mfkiwl/vigoleno-V1.0-A13SOM/Documents/https.docx

Ram

https://www.digikey.com/products/en/integrated-circuits-ics/memory/774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

Nand

https://www.digikey.com/product-detail/en/cypress-semiconductor-corp/S34ML08G201TFI000/1274-1099-ND/4457676

Resitor networks

22R

https://www.digikey.in/product-detail/en/yageo/YC124-JR-0722RL/YC124J-22CT-ND/1005508

10K

https://www.digikey.com/product-detail/en/yageo/YC124-JR-0710KL/YC124J-10KCT-ND/1005575

100K

https://www.digikey.com/product-detail/en/samsung-electro-mechanics/RP104PJ104CS/1276-6113-1-ND/3969085

Power

1.2V

https://www.digikey.in/product-detail/en/renesas-electronics-america-inc/ISL8022IRZ/ISL8022IRZ-ND/2360908

1.5V

https://www.digikey.in/product-detail/en/texas-instruments/TLV62569PDDCT/296-47088-1-ND/7596469

3.0V

https://www.digikey.in/product-detail/en/texas-instruments/TPS62233DRYR/296-46475-1-ND/7033648

3.3V & 5.0V

http://thegioiic.com/products/xl4015

SN74ALVC244DGVR

https://www.digikey.com/product-detail/en/texas-instruments/SN74ALVC244DGVR/296-12862-1-ND/475995

2.2uH/2.1A INDUCTOR

https://www.digikey.com/product-detail/en/bourns-inc/SRN2512-2R2M/SRN2512-2R2MCT-ND/4867759

47uH/6.5A INDUCTOR

https://www.digikey.com/product-detail/en/bourns-inc/SRP1265A-470M/SRP1265A-470MCT-ND/4876720

USB SWITCH

https://www.digikey.com/product-detail/en/texas-instruments/TPS2066CD/296-30609-5-ND/3487218

VGA CONNECTOR

https://www.digikey.com/product-detail/en/omron-electronics-inc-emc-div/XM4L-1542-132/OR1096-ND/1829580

CMOS BATTERY

https://shopee.vn/Pin-ngu%E1%BB%93n-3-6v-60mA-4h-6mA-i.20802805.1079670766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

POWER SWITCH

https://www.digikey.com/product-detail/en/linear-technology-analog-devices/LTC4412HVIS6-TRPBF/LTC4412HVIS6-TRPBFCT-ND/4694483

HEATSINK

https://shopee.vn/Nh%C3%B4m-t%E1%BA%A3n-nhi%E1%BB%87t-h%C3%A0ng-nh%E1%BA%ADp-kh%E1%BA%A9u-8cm-x-8cm-x-0.7cm-i.87361431.1483501040

RIPPER FILTER INDUCTOR 10uH/4.5A

https://www.digikey.com/product-detail/en/eaton/DR124-100-R/513-1431-1-ND/1555580

EEPROM

https://www.digikey.com/product-detail/en/microchip-technology/93LC66AT-I-OT/93LC66AT-I-OTCT-ND/857647

SCHOTTKY DIODE 10A/60V

https://www.digikey.com/product-detail/en/micro-commercial-co/SK106-TP/SK106-TPCT-ND/1306213

LM317

https://www.digikey.com/product-detail/en/on-semiconductor/LM317BD2TR4G/LM317BD2TR4GOSCT-ND/917939

ON/OFF SWITCH FOR POWER SUPPLY

https://sptshoponline.com/san-pham/cong-tac-bap-benh-6-chan-cong-tac-dao-chieu/
