mfkiwl/vigoleno-V1.0-A13SOM/Documents/BLX-A.pdf

## QuickTec sikringsholder BLX-A:

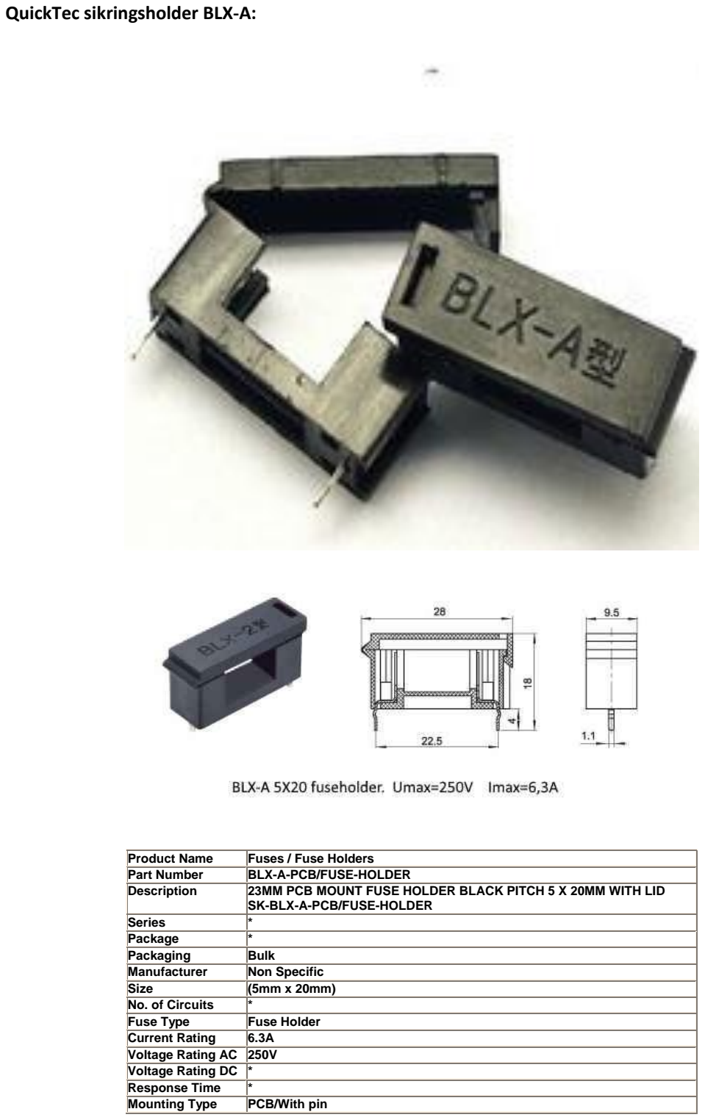
[picture p1: page 1]

Product Name | Fuses / Fuse Holders
Part Number | BLX-A-PCB/FUSE-HOLDER
Description | 23MM PCB MOUNT FUSE HOLDER BLACK PITCH 5 X 20MM WITH LID SK-BLX-A-PCB/FUSE-HOLDER
Series | *
Package | *
Packaging | Bulk
Manufacturer | Non Specific
Size | (5mm x 20mm)
No. of Circuits | *
Fuse Type | Fuse Holder
Current Rating | 6.3A
Voltage Rating AC | 250V
Voltage Rating DC | *
Response Time | *
Mounting Type | PCB/With pin
