mfkiwl/vigoleno-V1.0-A13SOM/PCB/vigoleno/vigoleno-F.Cu.dxf

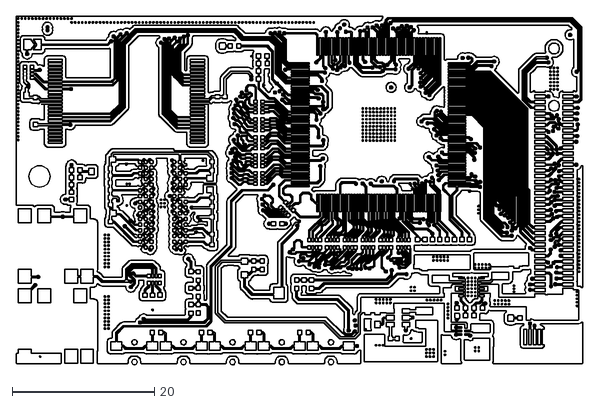
[picture p2: CAD file, 2019-08-09]
PCB/vigoleno/vigoleno-F.Cu.dxf
79.6 x 48.9
