mfkiwl/vigoleno-V1.0-A13SOM/PCB/vigoleno/vigoleno-Edge.Cuts.dxf

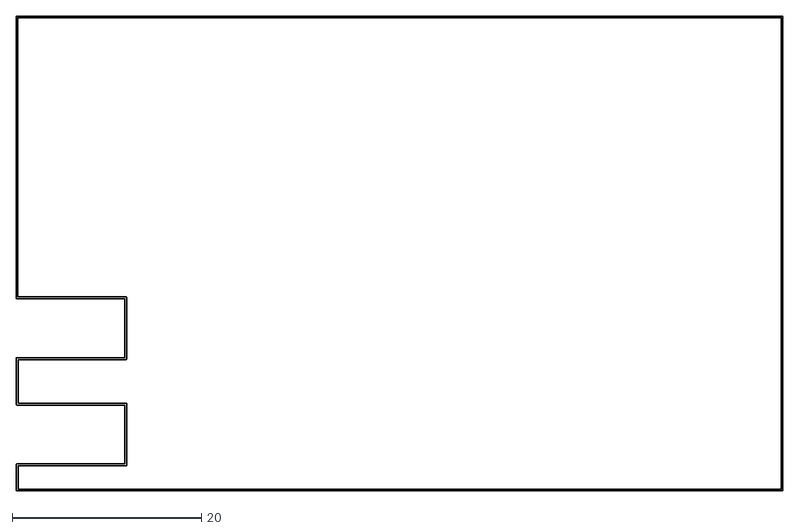
[picture p3: CAD file, 2019-08-09]
PCB/vigoleno/vigoleno-Edge.Cuts.dxf
81.0 x 50.2
