mfkiwl/vigoleno-V1.0-A13SOM/(list of files, cad)

Other CAD files:
PCB/vigoleno/vigoleno-F.SilkS.dxf
