mfkiwl/vigoleno-V1.0-A13SOM/Documents/2631-2XXMXXXTNXX.pdf

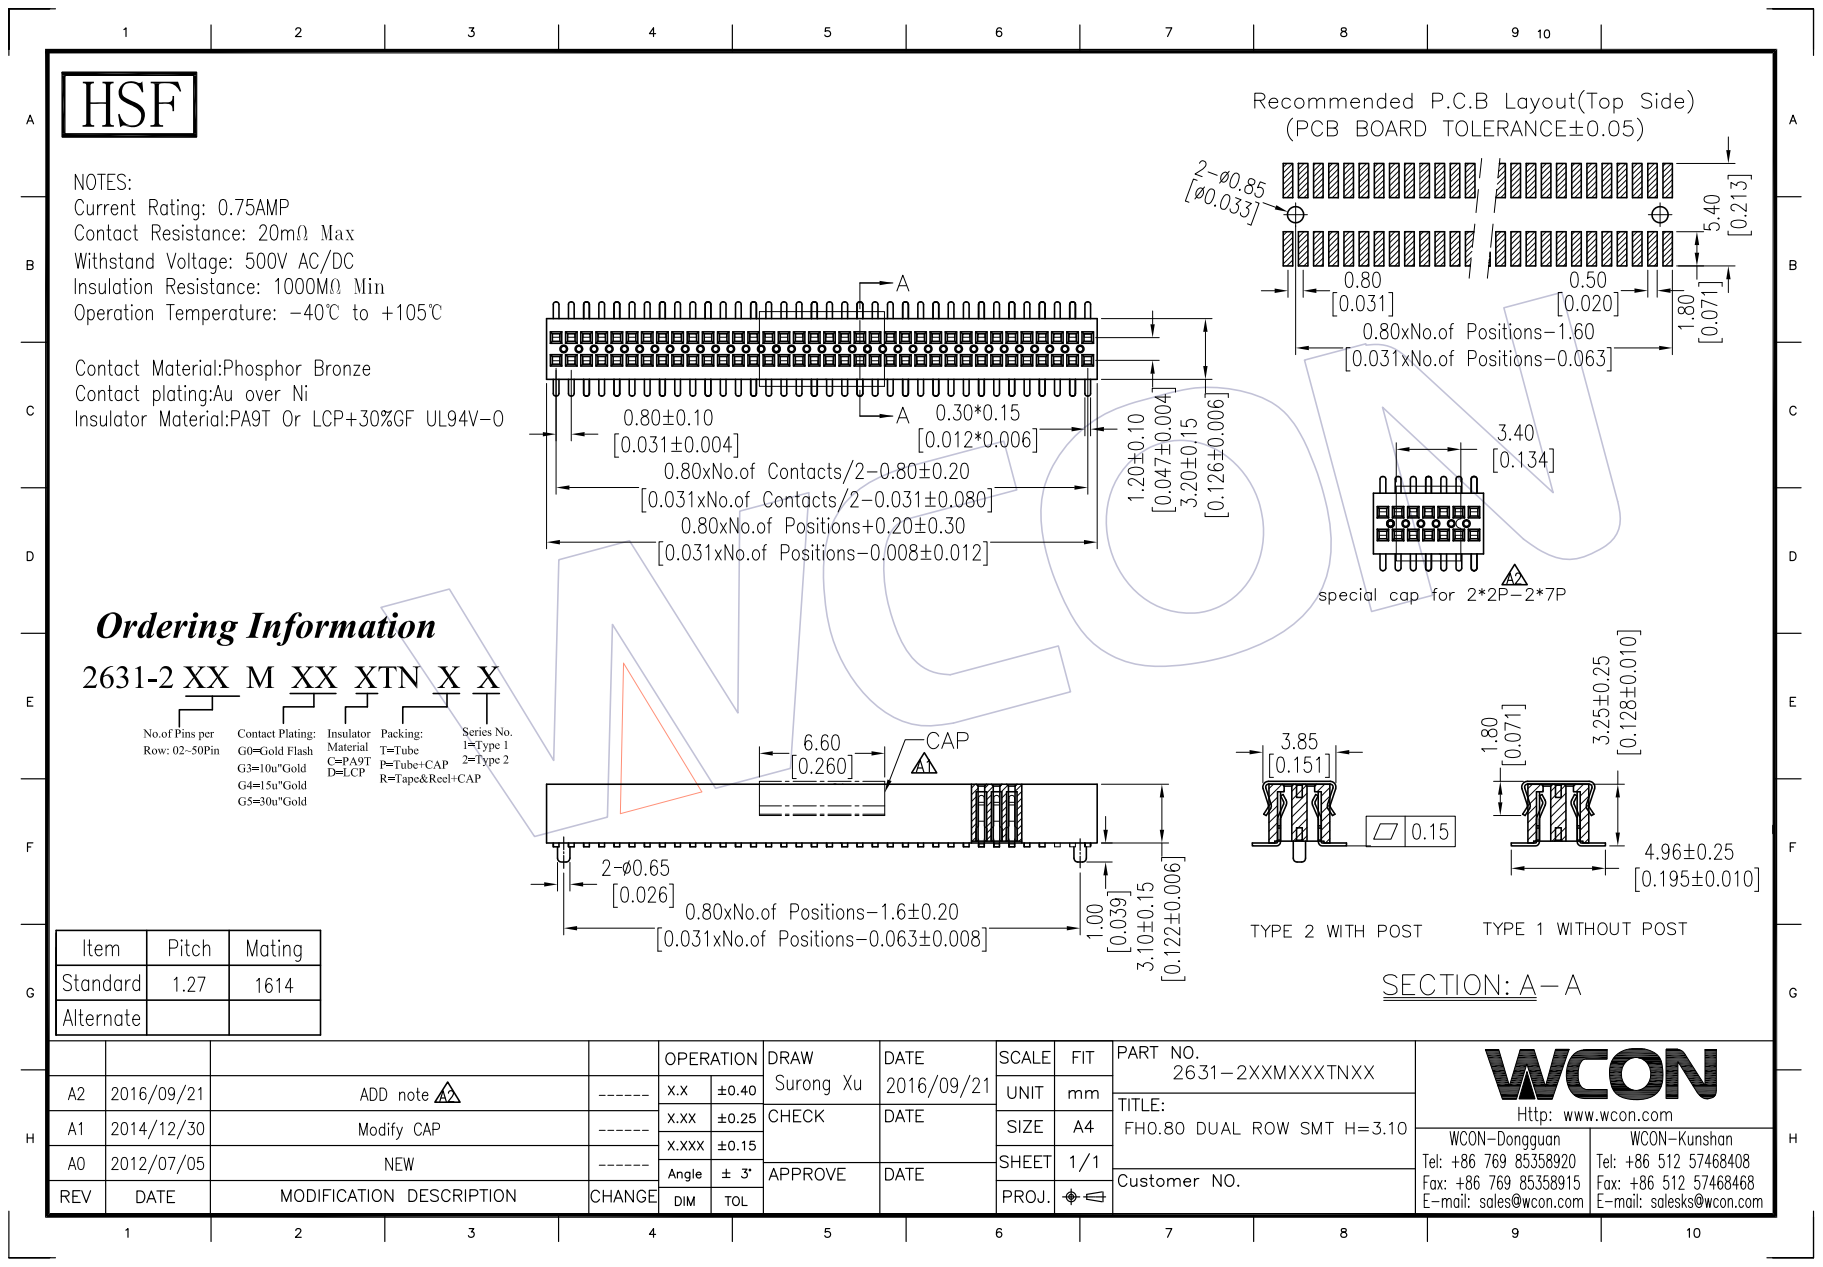
[picture p4: page 1]
