mfkiwl/vigoleno-V1.0-A13SOM/PCB/vigoleno/vigoleno.kicad_pcb

## KiCad design PCB/vigoleno/vigoleno.kicad_pcb (2019-08-09)

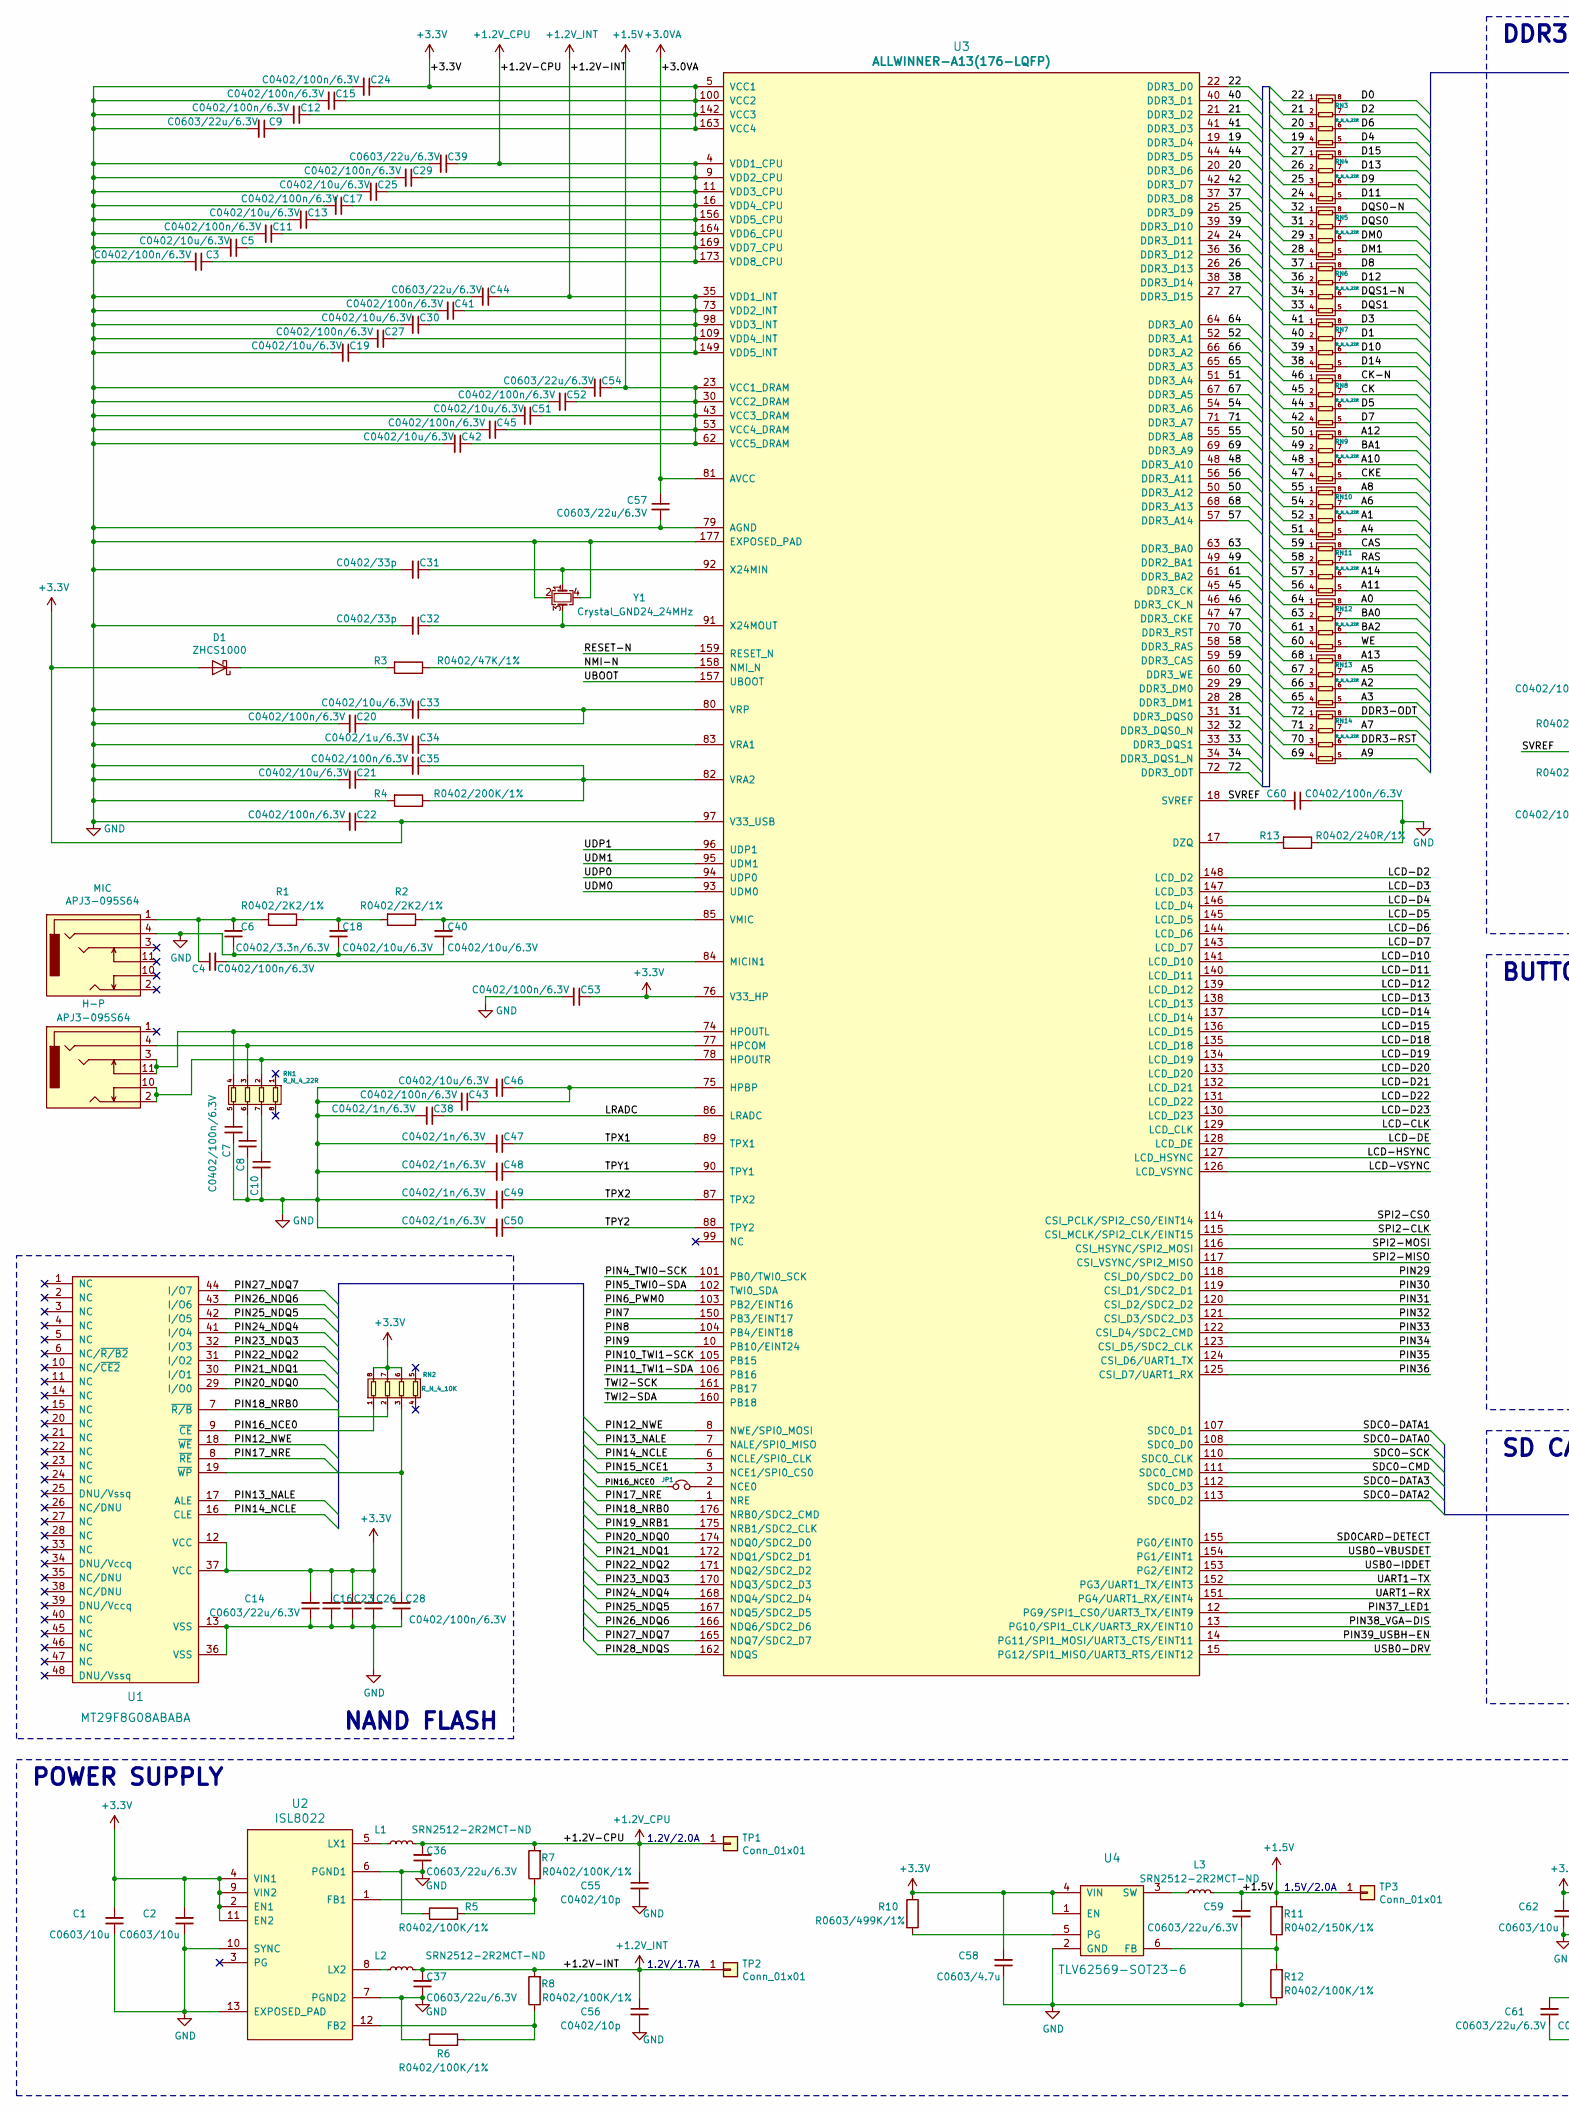
[picture p5: schematic vigoleno.sch, VIGOLENO SYSTEM ON MODULE, part in row 1, column 1]

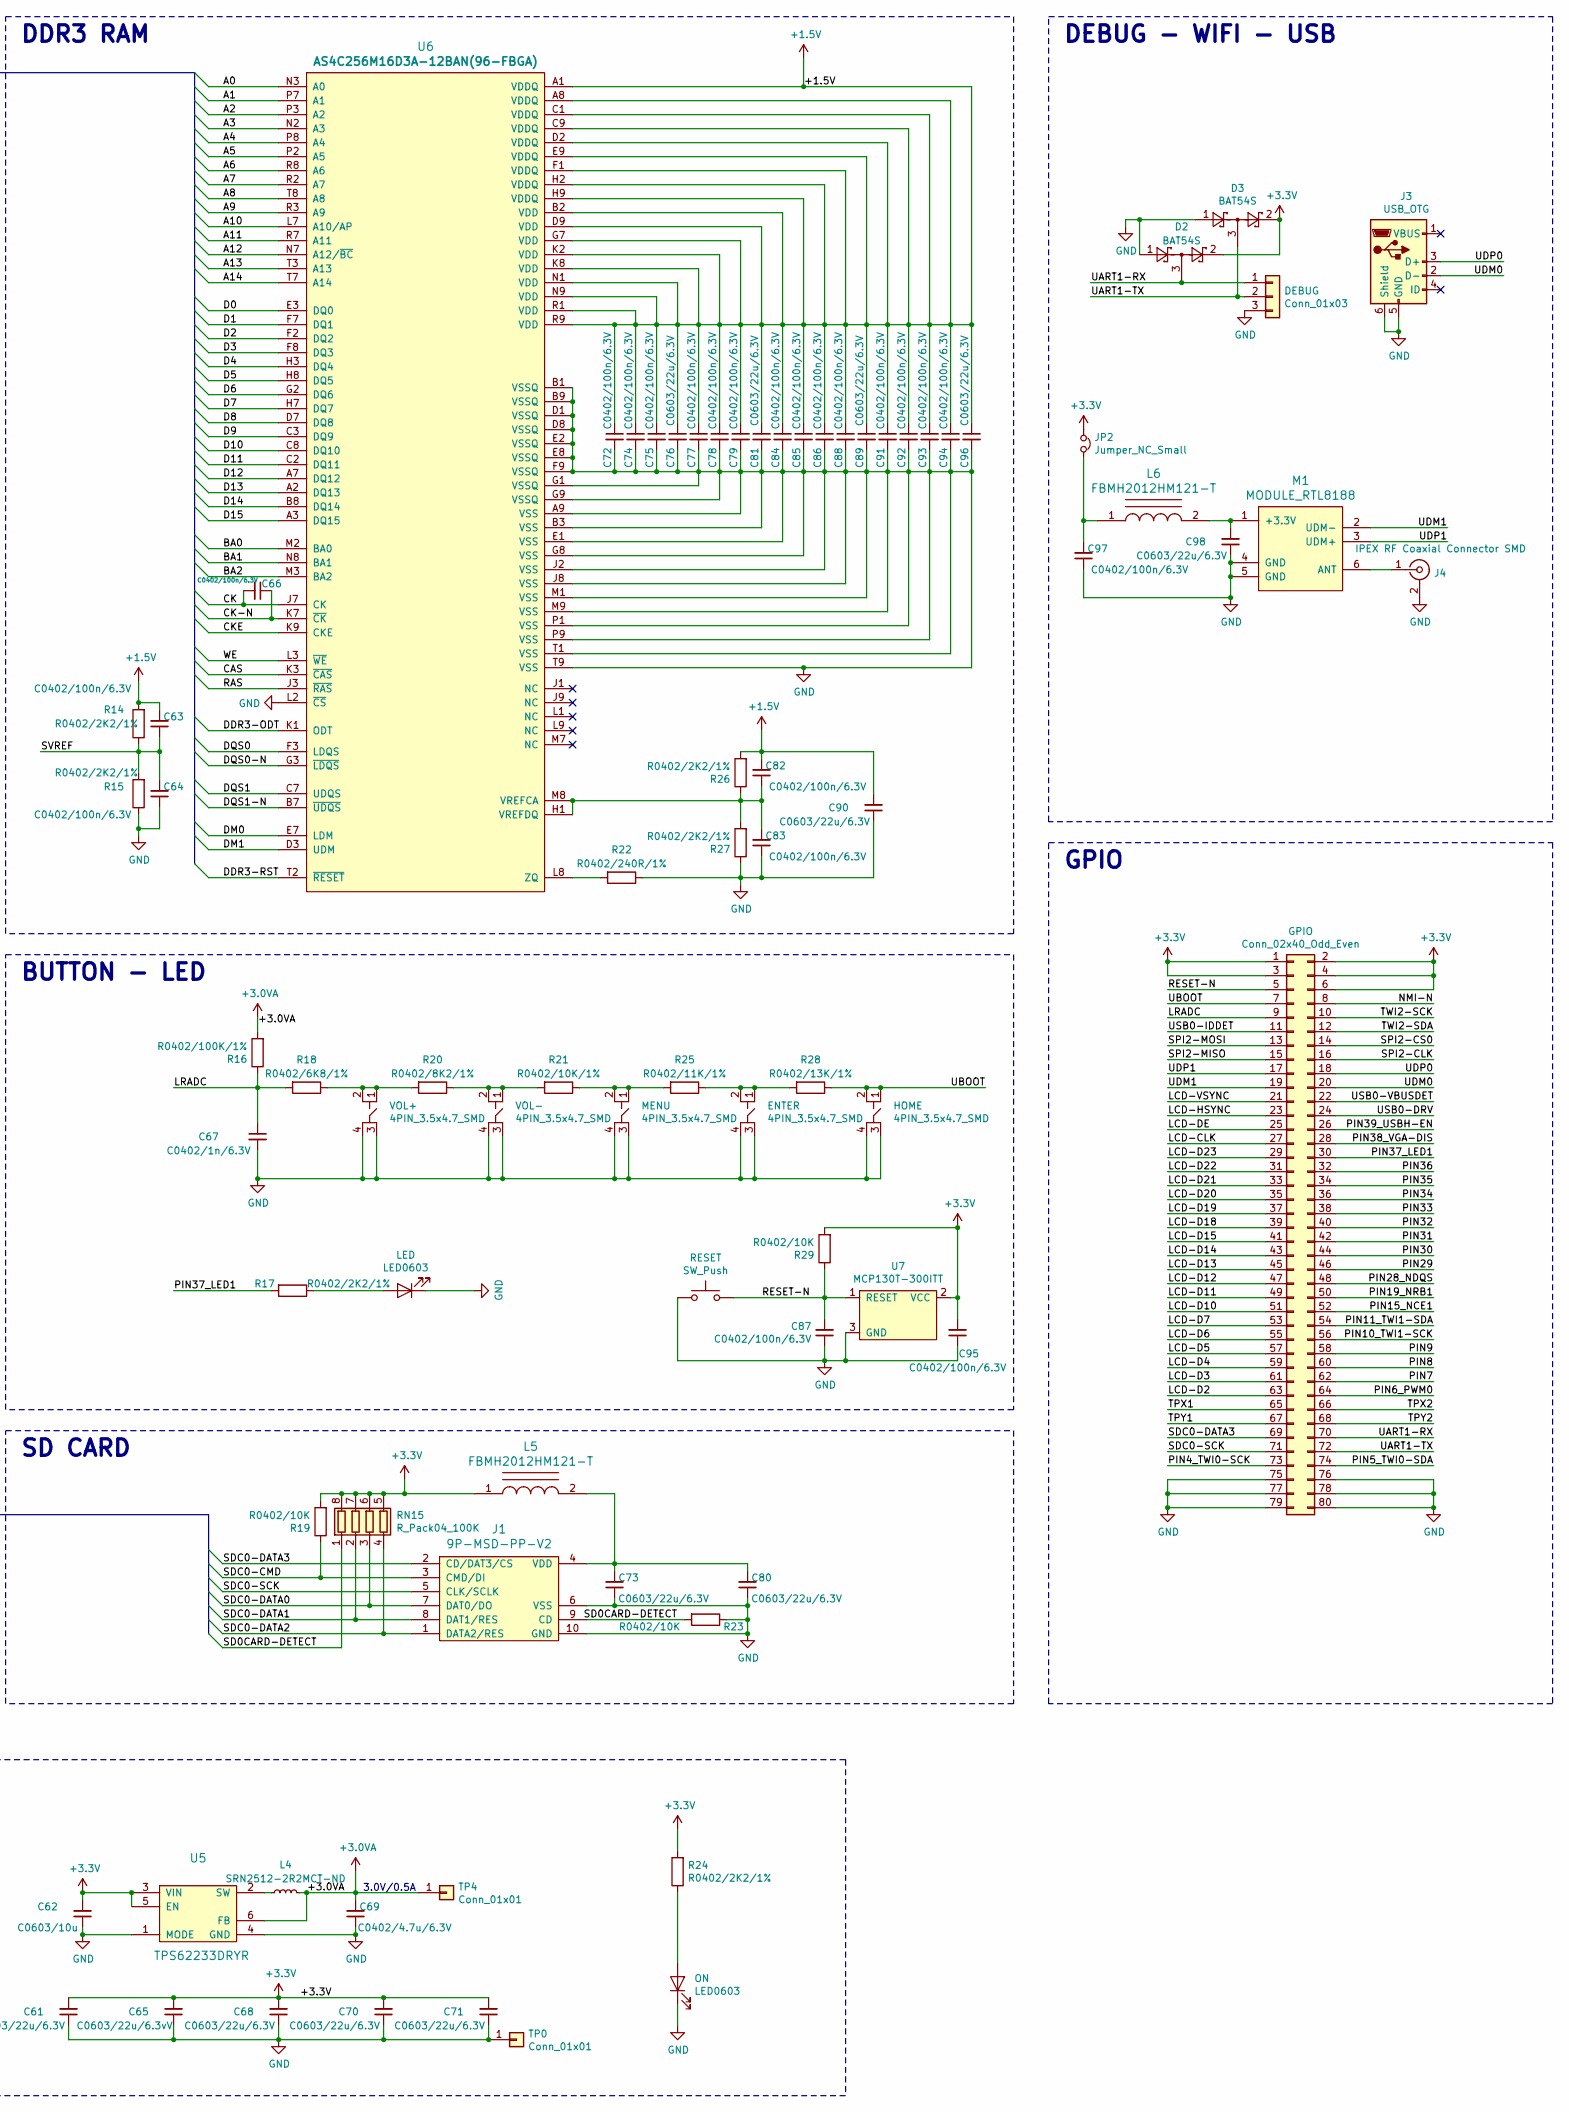
[picture p6: schematic vigoleno.sch, VIGOLENO SYSTEM ON MODULE, part in row 1, column 2]

Parts:
C1, C2, C62: C0603/10u; C0603_HandSoldering
C3, C4, C7, C8, C10, C11, C12, C15, C16, C17, C20, C22, C23, C24, C26, C27, C28, C29, C35, C41, C43, C45, C52, C53, C60, C63, C64, C66, C72, C74, C75, C77, C78, C79, C82, C83, C84, C85, C86, C87, C88, C91, C92, C93, C94, C95, C97: C0402/100n/6.3V; C0402_HandSoldering
C5, C13, C18, C19, C21, C25, C30, C33, C40, C42, C46, C51: C0402/10u/6.3V; C0402_HandSoldering
C6: C0402/3.3n/6.3V; C0402_HandSoldering
C9, C14, C36, C37, C39, C44, C54, C57, C59, C61, C68, C70, C71, C73, C76, C80, C81, C89, C90, C96, C98: C0603/22u/6.3V; C0603_HandSoldering
C31, C32: C0402/33p; C0402_HandSoldering
C34: C0402/1u/6.3V; C0402_HandSoldering
C38, C47, C48, C49, C50, C67: C0402/1n/6.3V; C0402_HandSoldering
C55, C56: C0402/10p; C0402_HandSoldering
C58: C0603/4.7u; C0603_HandSoldering
C65: C0603/22u/6.3vV; C0603_HandSoldering
C69: C0402/4.7u/6.3V; C0402_HandSoldering
D1: ZHCS1000; SOT-23
D2, D3: BAT54S; SOT-23
DEBUG: Conn_01x03; Molex_CLIK-Mate_502585-0370_1x03-1MP_P1.50mm_Horizontal
ENTER: 4PIN_3.5x4.7_SMD
GPIO: Conn_02x40_Odd_Even; 2x40_pitch 0.8mm_SMD_header
H-P: APJ3-095S64; APJ3-095S64(Board_Cutout)
HOME: 4PIN_3.5x4.7_SMD
J1: 9P-MSD-PP-V2; MicroSD_9Pin_MSD-PP-V2
J3: USB_OTG; USB_Micro_3MV2
J4: IPEX RF Coaxial Connector SMD; U.FL_Hirose_U.FL-R-SMT-1_Vertical
JP1, JP2: Jumper_NC_Small; SolderJumper-2_P1.3mm_Open_TrianglePad1.0x1.5mm
L1, L2, L3, L4: SRN2512-2R2MCT-ND; Inductor_SRN2512_Series
L5, L6: FBMH2012HM121-T; L_0805_2012Metric
LED: LED0603; LED_0603_1608Metric
M1: MODULE_RTL8188; RTL8188_MODULE
MENU: 4PIN_3.5x4.7_SMD
MIC: APJ3-095S64; APJ3-095S64(Board_Cutout)
ON: LED0603; LED_0603_1608Metric
R1, R2, R14, R15, R17, R24, R26, R27: R0402/2K2/1%; R0402_HandSoldering
R3: R0402/47K/1%; R0402_HandSoldering
R4: R0402/200K/1%; R0402_HandSoldering
R5, R6, R7, R8, R12, R16: R0402/100K/1%; R0402_HandSoldering
R10: R0603/499K/1%; R0603_HandSoldering
R11: R0402/150K/1%; R0402_HandSoldering
R13, R22: R0402/240R/1%; R0402_HandSoldering
R18: R0402/6K8/1%; R0402_HandSoldering
R19, R23, R29: R0402/10K; R0402_HandSoldering
R20: R0402/8K2/1%; R0402_HandSoldering
R21: R0402/10K/1%; R0402_HandSoldering
R25: R0402/11K/1%; R0402_HandSoldering
R28: R0402/13K/1%; R0402_HandSoldering
RESET: SW_Push; SW_3x6x5_2Pin_SMD
RN1, RN3, RN4, RN5, RN6, RN7, RN8, RN9, RN10, RN11, RN12, RN13, RN14: R_N_4_22R; R_Array_0804_Convex_4x0402
RN2: R_N_4_10K; R_Array_0804_Convex_4x0402
RN15: R_Pack04_100K; R_Array_Convex_4x0603
TP0, TP1, TP2, TP3, TP4: Conn_01x01; TestPoint_Pad_D1.0mm
U1: MT29F8G08ABABA; S34ML08G2(48-TSOP)
U2: ISL8022; DFN-12-1EP_3x4mm_P0.5mm_EP1.7x3.3mm
U3: ALLWINNER-A13(176-LQFP); AllWinner-A13(176-LQFP)
U4: TLV62569-SOT23-6; SOT-23-6
U5: TPS62233DRYR; TPS62233DRYR_6_UFDFN
U6: AS4C256M16D3A-12BAN(96-FBGA)
U7: MCP130T-300ITT; SOT-23
VOL+: 4PIN_3.5x4.7_SMD
VOL-: 4PIN_3.5x4.7_SMD
Y1: Crystal_GND24_24MHz; Crystal_SMD_SeikoEpson_TSX3225-4pin_3.2x2.5mm_HandSoldering

Connections:
+3V3: C1.2, C2.2, C9.1, C12.1, C14.2, C15.1, C16.2, C22.1, C23.2, C24.1, C26.2, C53.1, C58.2, C61.2, C62.2, C65.2, C68.2, C70.2, C71.2, C95.2, D1.1 (A), D2.2, D3.2, GPIO.1, GPIO.2, GPIO.3, GPIO.4, GPIO.6, JP2.1, L5.1, R10.1, R19.2, R24.2, R29.2, RN2.6, RN2.7, RN2.8, RN15.5 (R4.2), RN15.6 (R3.2), RN15.7 (R2.2), RN15.8 (R1.2), U1.12 (VCC), U1.37 (VCC), U2.2 (EN1), U2.4 (VIN1), U2.9 (VIN2), U2.11 (EN2), U3.5 (VCC1), U3.76 (V33_HP), U3.97 (V33_USB), U3.100 (VCC2), U3.142 (VCC3), U3.163 (VCC4), U4.1 (EN), U4.4 (VIN), U5.3 (VIN), U5.5 (EN), U7.2 (VCC)
/19: RN3.4, U3.19 (DDR3_D4)
/20: RN3.3, U3.20 (DDR3_D6)
/21: RN3.2, U3.21 (DDR3_D2)
/22: RN3.1, U3.22 (DDR3_D0)
/24: RN4.4, U3.24 (DDR3_D11)
/25: RN4.3, U3.25 (DDR3_D9)
/26: RN4.2, U3.26 (DDR3_D13)
/27: RN4.1, U3.27 (DDR3_D15)
/28: RN5.4, U3.28 (DDR3_DM1)
/29: RN5.3, U3.29 (DDR3_DM0)
/31: RN5.2, U3.31 (DDR3_DQS0)
/32: RN5.1, U3.32 (DDR3_DQS0_N)
/33: RN6.4, U3.33 (DDR3_DQS1)
/34: RN6.3, U3.34 (DDR3_DQS1_N)
/36: RN6.2, U3.36 (DDR3_D12)
/37: RN6.1, U3.37 (DDR3_D8)
/38: RN7.4, U3.38 (DDR3_D14)
/39: RN7.3, U3.39 (DDR3_D10)
/40: RN7.2, U3.40 (DDR3_D1)
/41: RN7.1, U3.41 (DDR3_D3)
/42: RN8.4, U3.42 (DDR3_D7)
/44: RN8.3, U3.44 (DDR3_D5)
/45: RN8.2, U3.45 (DDR3_CK)
/46: RN8.1, U3.46 (DDR3_CK_N)
/47: RN9.4, U3.47 (DDR3_CKE)
/48: RN9.3, U3.48 (DDR3_A10)
/49: RN9.2, U3.49 (DDR2_BA1)
/50: RN9.1, U3.50 (DDR3_A12)
/51: RN10.4, U3.51 (DDR3_A4)
/52: RN10.3, U3.52 (DDR3_A1)
/54: RN10.2, U3.54 (DDR3_A6)
/55: RN10.1, U3.55 (DDR3_A8)
/56: RN11.4, U3.56 (DDR3_A11)
/57: RN11.3, U3.57 (DDR3_A14)
/58: RN11.2, U3.58 (DDR3_RAS)
/59: RN11.1, U3.59 (DDR3_CAS)
/60: RN12.4, U3.60 (DDR3_WE)
/61: RN12.3, U3.61 (DDR3_BA2)
/63: RN12.2, U3.63 (DDR3_BA0)
/64: RN12.1, U3.64 (DDR3_A0)
/65: RN13.4, U3.65 (DDR3_A3)
/66: RN13.3, U3.66 (DDR3_A2)
/67: RN13.2, U3.67 (DDR3_A5)
/68: RN13.1, U3.68 (DDR3_A13)
/69: RN14.4, U3.69 (DDR3_A9)
/70: RN14.3, U3.70 (DDR3_RST)
/71: RN14.2, U3.71 (DDR3_A7)
/72: RN14.1, U3.72 (DDR3_ODT)
/+1.2V-CPU: C3.1, C5.1, C11.1, C13.1, C17.1, C25.1, C29.1, C36.2, C39.1, C55.1, L1.2, R7.2, TP1.1, U3.4 (VDD1_CPU), U3.9 (VDD2_CPU), U3.11 (VDD3_CPU), U3.16 (VDD4_CPU), U3.156 (VDD5_CPU), U3.164 (VDD6_CPU), U3.169 (VDD7_CPU), U3.173 (VDD8_CPU)
/+1.2V-INT: C19.1, C27.1, C30.1, C37.2, C41.1, C44.1, C56.1, L2.2, R8.2, TP2.1, U3.35 (VDD1_INT), U3.73 (VDD2_INT), U3.98 (VDD3_INT), U3.109 (VDD4_INT), U3.149 (VDD5_INT)
/+3.0VA: C57.1, C69.2, L4.2, R16.2, TP4.1, U3.81 (AVCC), U5.6 (FB)
/A0: RN12.8, U6.N3 (A0)
/A1: RN10.6, U6.P7 (A1)
/A2: RN13.6, U6.P3 (A2)
/A3: RN13.5, U6.N2 (A3)
/A4: RN10.5, U6.P8 (A4)
/A5: RN13.7, U6.P2 (A5)
/A6: RN10.7, U6.R8 (A6)
/A7: RN14.7, U6.R2 (A7)
/A8: RN10.8, U6.T8 (A8)
/A9: RN14.5, U6.R3 (A9)
/A10: RN9.6, U6.L7 (A10/AP)
/A11: RN11.5, U6.R7 (A11)
/A12: RN9.8, U6.N7 (A12/~BC)
/A13: RN13.8, U6.T3 (A13)
/A14: RN11.6, U6.T7 (A14)
/BA0: RN12.7, U6.M2 (BA0)
/BA1: RN9.7, U6.N8 (BA1)
/BA2: RN12.6, U6.M3 (BA2)
/CAS: RN11.8, U6.K3 (~CAS)
/CK: C66.2, RN8.7, U6.J7 (CK)
/CK-N: C66.1, RN8.8, U6.K7 (~CK)
/CKE: RN9.5, U6.K9 (CKE)
/D0: RN3.8, U6.E3 (DQ0)
/D1: RN7.7, U6.F7 (DQ1)
/D2: RN3.7, U6.F2 (DQ2)
/D3: RN7.8, U6.F8 (DQ3)
/D4: RN3.5, U6.H3 (DQ4)
/D5: RN8.6, U6.H8 (DQ5)
/D6: RN3.6, U6.G2 (DQ6)
/D7: RN8.5, U6.H7 (DQ7)
/D8: RN6.8, U6.D7 (DQ8)
/D9: RN4.6, U6.C3 (DQ9)
/D10: RN7.6, U6.C8 (DQ10)
/D11: RN4.5, U6.C2 (DQ11)
/D12: RN6.7, U6.A7 (DQ12)
/D13: RN4.7, U6.A2 (DQ13)
/D14: RN7.5, U6.B8 (DQ14)
/D15: RN4.8, U6.A3 (DQ15)
/DDR3-ODT: RN14.8, U6.K1 (ODT)
/DDR3-RST: RN14.6, U6.T2 (~RESET)
/DM0: RN5.6, U6.E7 (LDM)
/DM1: RN5.5, U6.D3 (UDM)
/DQS0: RN5.7, U6.F3 (LDQS)
/DQS0-N: RN5.8, U6.G3 (~LDQS)
/DQS1: RN6.5, U6.C7 (UDQS)
/DQS1-N: RN6.6, U6.B7 (~UDQS)
/LCD-CLK: GPIO.27, U3.129 (LCD_CLK)
/LCD-D2: GPIO.63, U3.148 (LCD_D2)
/LCD-D3: GPIO.61, U3.147 (LCD_D3)
/LCD-D4: GPIO.59, U3.146 (LCD_D4)
/LCD-D5: GPIO.57, U3.145 (LCD_D5)
/LCD-D6: GPIO.55, U3.144 (LCD_D6)
/LCD-D7: GPIO.53, U3.143 (LCD_D7)
/LCD-D10: GPIO.51, U3.141 (LCD_D10)
/LCD-D11: GPIO.49, U3.140 (LCD_D11)
/LCD-D12: GPIO.47, U3.139 (LCD_D12)
/LCD-D13: GPIO.45, U3.138 (LCD_D13)
/LCD-D14: GPIO.43, U3.137 (LCD_D14)
/LCD-D15: GPIO.41, U3.136 (LCD_D15)
/LCD-D18: GPIO.39, U3.135 (LCD_D18)
/LCD-D19: GPIO.37, U3.134 (LCD_D19)
/LCD-D20: GPIO.35, U3.133 (LCD_D20)
/LCD-D21: GPIO.33, U3.132 (LCD_D21)
/LCD-D22: GPIO.31, U3.131 (LCD_D22)
/LCD-D23: GPIO.29, U3.130 (LCD_D23)
/LCD-DE: GPIO.25, U3.128 (LCD_DE)
/LCD-HSYNC: GPIO.23, U3.127 (LCD_HSYNC)
/LCD-VSYNC: GPIO.21, U3.126 (LCD_VSYNC)
/LRADC: C38.1, C67.1, GPIO.9, R16.1, R18.2, U3.86 (LRADC)
/NMI-N: GPIO.8, R3.1, U3.158 (NMI_N)
/PIN4_TWI0-SCK: GPIO.73, U3.101 (PB0/TWI0_SCK)
/PIN5_TWI0-SDA: GPIO.74, U3.102 (TWI0_SDA)
/PIN6_PWM0: GPIO.64, U3.103 (PB2/EINT16)
/PIN7: GPIO.62, U3.150 (PB3/EINT17)
/PIN8: GPIO.60, U3.104 (PB4/EINT18)
/PIN9: GPIO.58, U3.10 (PB10/EINT24)
/PIN10_TWI1-SCK: GPIO.56, U3.105 (PB15)
/PIN11_TWI1-SDA: GPIO.54, U3.106 (PB16)
/PIN12_NWE: U1.18 (~WE), U3.8 (NWE/SPI0_MOSI)
/PIN13_NALE: U1.17 (ALE), U3.7 (NALE/SPI0_MISO)
/PIN14_NCLE: U1.16 (CLE), U3.6 (NCLE/SPI0_CLK)
/PIN15_NCE1: GPIO.52, U3.3 (NCE1/SPI0_CS0)
/PIN16_NCE0: JP1.1, RN2.1, U1.9 (~CE)
/PIN17_NRE: U1.8 (~RE), U3.1 (NRE)
/PIN18_NRB0: RN2.2, U1.7 (~R/B), U3.176 (NRB0/SDC2_CMD)
/PIN19_NRB1: GPIO.50, U3.175 (NRB1/SDC2_CLK)
/PIN20_NDQ0: U1.29 (I/O0), U3.174 (NDQ0/SDC2_D0)
/PIN21_NDQ1: U1.30 (I/O1), U3.172 (NDQ1/SDC2_D1)
/PIN22_NDQ2: U1.31 (I/O2), U3.171 (NDQ2/SDC2_D2)
/PIN23_NDQ3: U1.32 (I/O3), U3.170 (NDQ3/SDC2_D3)
/PIN24_NDQ4: U1.41 (I/O4), U3.168 (NDQ4/SDC2_D4)
/PIN25_NDQ5: U1.42 (I/O5), U3.167 (NDQ5/SDC2_D5)
/PIN26_NDQ6: U1.43 (I/O6), U3.166 (NDQ6/SDC2_D6)
/PIN27_NDQ7: U1.44 (I/O7), U3.165 (NDQ7/SDC2_D7)
/PIN28_NDQS: GPIO.48, U3.162 (NDQS)
/PIN29: GPIO.46, U3.118 (CSI_D0/SDC2_D0)
/PIN30: GPIO.44, U3.119 (CSI_D1/SDC2_D1)
/PIN31: GPIO.42, U3.120 (CSI_D2/SDC2_D2)
/PIN32: GPIO.40, U3.121 (CSI_D3/SDC2_D3)
/PIN33: GPIO.38, U3.122 (CSI_D4/SDC2_CMD)
/PIN34: GPIO.36, U3.123 (CSI_D5/SDC2_CLK)
/PIN35: GPIO.34, U3.124 (CSI_D6/UART1_TX)
/PIN36: GPIO.32, U3.125 (CSI_D7/UART1_RX)
/PIN37_LED1: GPIO.30, R17.2, U3.12 (PG9/SPI1_CS0/UART3_TX/EINT9)
/PIN38_VGA-DIS: GPIO.28, U3.13 (PG10/SPI1_CLK/UART3_RX/EINT10)
/PIN39_USBH-EN: GPIO.26, U3.14 (PG11/SPI1_MOSI/UART3_CTS/EINT11)
/RAS: RN11.7, U6.J3 (~RAS)
/RESET-N: C87.2, GPIO.5, R29.1, RESET.2, U3.159 (RESET_N), U7.1 (RESET)
/SD0CARD-DETECT: J1.9 (CD), R23.2, RN15.1 (R1.1), U3.155 (PG0/EINT0)
/SDC0-CMD: J1.3 (CMD/DI), R19.1, U3.111 (SDC0_CMD)
/SDC0-DATA0: J1.7 (DAT0/DO), RN15.3 (R3.1), U3.108 (SDC0_D0)
/SDC0-DATA1: J1.8 (DAT1/RES), RN15.2 (R2.1), U3.107 (SDC0_D1)
/SDC0-DATA2: J1.1 (DATA2/RES), RN15.4 (R4.1), U3.113 (SDC0_D2)
/SDC0-DATA3: GPIO.69, J1.2 (CD/DAT3/CS), U3.112 (SDC0_D3)
/SDC0-SCK: GPIO.71, J1.5 (CLK/SCLK), U3.110 (SDC0_CLK)
/SPI2-CLK: GPIO.16, U3.115 (CSI_MCLK/SPI2_CLK/EINT15)
/SPI2-CS0: GPIO.14, U3.114 (CSI_PCLK/SPI2_CS0/EINT14)
/SPI2-MISO: GPIO.15, U3.117 (CSI_VSYNC/SPI2_MISO)
/SPI2-MOSI: GPIO.13, U3.116 (CSI_HSYNC/SPI2_MOSI)
/SVREF: C60.2, C63.1, C64.2, R14.1, R15.2, U3.18 (SVREF)
/TPX1: C47.1, GPIO.65, U3.89 (TPX1)
/TPX2: C49.1, GPIO.66, U3.87 (TPX2)
/TPY1: C48.1, GPIO.67, U3.90 (TPY1)
/TPY2: C50.1, GPIO.68, U3.88 (TPY2)
/TWI2-SCK: GPIO.10, U3.161 (PB17)
/TWI2-SDA: GPIO.12, U3.160 (PB18)
/UART1-RX: D2.3, DEBUG.1, GPIO.70, U3.151 (PG4/UART1_RX/EINT4)
/UART1-TX: D3.3, DEBUG.2, GPIO.72, U3.152 (PG3/UART1_TX/EINT3)
/UBOOT: GPIO.7, HOME.1 (A), HOME.2 (B), R28.1, U3.157 (UBOOT)
/UDM0: GPIO.20, J3.2 (D-), U3.93 (UDM0)
/UDM1: GPIO.19, M1.2 (UDM-), U3.95 (UDM1)
/UDP0: GPIO.18, J3.3 (D+), U3.94 (UDP0)
/UDP1: GPIO.17, M1.3 (UDM+), U3.96 (UDP1)
/USB0-DRV: GPIO.24, U3.15 (PG12/SPI1_MISO/UART3_RTS/EINT12)
/USB0-IDDET: GPIO.11, U3.153 (PG2/EINT2)
/USB0-VBUSDET: GPIO.22, U3.154 (PG1/EINT1)
/WE: RN12.5, U6.L3 (~WE)
GND: C1.1, C2.1, C3.2, C5.2, C7.2, C8.2, C9.2, C10.2, C11.2, C12.2, C13.2, C14.1, C15.2, C16.1, C17.2, C18.1, C19.2, C20.2, C21.2, C22.2, C23.1, C24.2, C25.2, C26.1, C27.2, C28.1, C29.2, C30.2, C31.2, C32.2, C33.2, C34.2, C35.2, C36.1, C37.1, C38.2, C39.2, C40.1, C41.2, C42.2, C43.2, C44.2, C45.2, C46.2, C47.2, C48.2, C49.2, C50.2, C51.2, C52.2, C53.2, C54.2, C55.2, C56.2, C57.2, C58.1, C59.1, C60.1, C61.1, C62.1, C64.1, C65.1, C67.2, C68.1, C69.1, C70.1, C71.1, C72.2, C73.1, C74.2, C75.2, C76.2, C77.2, C78.2, C79.2, C80.1, C81.2, C83.1, C84.2, C85.2, C86.2, C87.1, C88.2, C89.2, C90.1, C91.2, C92.2, C93.2, C94.2, C95.1, C96.2, C97.1, C98.1, D2.1, D3.1, DEBUG.3, ENTER.3 (C), ENTER.4 (D), GPIO.75, GPIO.76, GPIO.77, GPIO.78, GPIO.79, GPIO.80, HOME.3 (C), HOME.4 (D), J1.6 (VSS), J1.10 (GND), J3.5 (GND), J3.6 (Shield), J4.2 (Ext), LED.1 (K), M1.4 (GND), M1.5 (GND), MENU.3 (C), MENU.4 (D), MIC.4, ON.1 (K), R4.2, R5.1, R6.1, R12.1, R13.1, R15.1, R22.1, R23.1, R27.1, RESET.1, TP0.1, U1.13 (VSS), U1.36 (VSS), U2.6 (PGND1), U2.7 (PGND2), U2.10 (SYNC), U2.13 (EXPOSED_PAD), U3.79 (AGND), U3.177 (EXPOSED_PAD), U4.2 (GND), U5.1 (MODE), U5.4 (GND), U6.A9 (VSS), U6.B1 (VSSQ), U6.B3 (VSS), U6.B9 (VSSQ), U6.D1 (VSSQ), U6.D8 (VSSQ), U6.E1 (VSS), U6.E2 (VSSQ), U6.E8 (VSSQ), U6.F9 (VSSQ), U6.G1 (VSSQ), U6.G8 (VSS), U6.G9 (VSSQ), U6.J2 (VSS), U6.J8 (VSS), U6.L2 (~CS), U6.M1 (VSS), U6.M9 (VSS), U6.P1 (VSS), U6.P9 (VSS), U6.T1 (VSS), U6.T9 (VSS), U7.3 (GND), VOL+.3 (C), VOL+.4 (D), VOL-.3 (C), VOL-.4 (D), Y1.2, Y1.4
unnamed: C4.1, C6.2, MIC.1, R1.2
unnamed: C4.2, U3.84 (MICIN1)
unnamed: C7.1, RN1.5
unnamed: C8.1, RN1.6
unnamed: C10.1, RN1.7
unnamed: C18.2, R1.1, R2.2
unnamed: C20.1, C33.1, U3.80 (VRP)
unnamed: C21.1, C35.1, R4.1, U3.82 (VRA2)
unnamed: C28.2, RN2.3, U1.19 (~WP)
unnamed: C31.1, U3.92 (X24MIN), Y1.1
unnamed: C32.1, U3.91 (X24MOUT), Y1.3
unnamed: C34.1, U3.83 (VRA1)
unnamed: C40.2, R2.1, U3.85 (VMIC)
unnamed: C43.1, C46.1, U3.75 (HPBP)
unnamed: C73.2, C80.2, J1.4 (VDD), L5.2
unnamed: C82.1, C83.2, R26.1, R27.2, U6.H1 (VREFDQ), U6.M8 (VREFCA)
unnamed: C97.2, JP2.2, L6.1
unnamed: C98.2, L6.2, M1.1 (+3.3V)
unnamed: D1.3 (K), R3.2
unnamed: ENTER.1 (A), ENTER.2 (B), R25.1, R28.2
unnamed: H-P.4, RN1.3, U3.77 (HPCOM)
unnamed: H-P.2, H-P.10, RN1.2, U3.78 (HPOUTR)
unnamed: H-P.3, H-P.11, RN1.4, U3.74 (HPOUTL)
unnamed: J4.1 (In), M1.6 (ANT)
unnamed: JP1.2, U3.2 (NCE0)
unnamed: L1.1, U2.5 (LX1)
unnamed: L2.1, U2.8 (LX2)
unnamed: L3.1, U4.3 (SW)
unnamed: L4.1, U5.2 (SW)
unnamed: LED.2 (A), R17.1
unnamed: MENU.1 (A), MENU.2 (B), R21.1, R25.2
unnamed: ON.2 (A), R24.1
unnamed: R5.2, R7.1, U2.1 (FB1)
unnamed: R6.2, R8.1, U2.12 (FB2)
unnamed: R10.2, U4.5 (PG)
unnamed: R11.1, R12.2, U4.6 (FB)
unnamed: R13.2, U3.17 (DZQ)
unnamed: R18.1, R20.2, VOL+.1 (A), VOL+.2 (B)
unnamed: R20.1, R21.2, VOL-.1 (A), VOL-.2 (B)
unnamed: R22.2, U6.L8 (ZQ)

Notes on the sheet:
1.2V/1.7A
1.2V/2.0A
1.5V/2.0A
3.0V/0.5A
DDR3 RAM
BUTTON - LED
SD CARD
GPIO
DEBUG - WIFI - USB
POWER SUPPLY
NAND FLASH

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
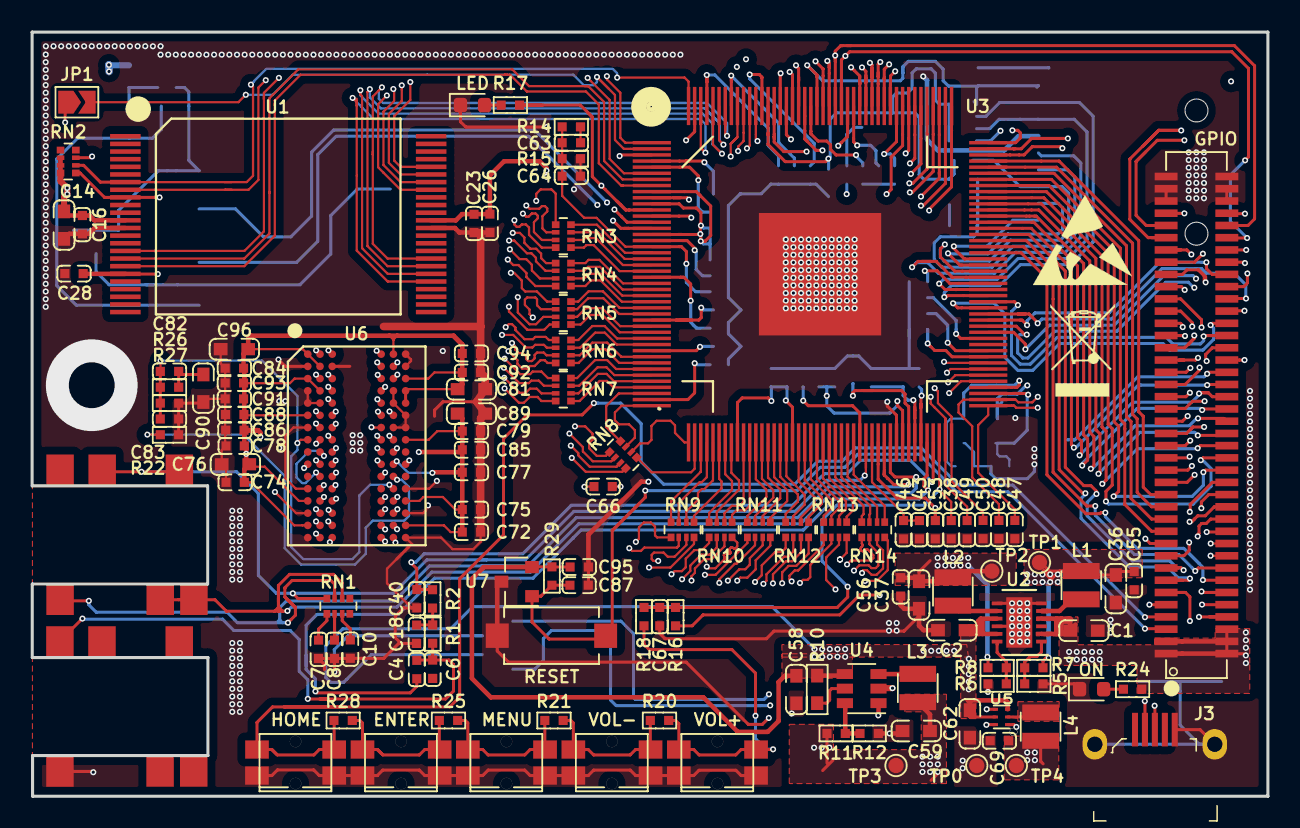
[picture p7: board vigoleno.kicad_pcb from above]

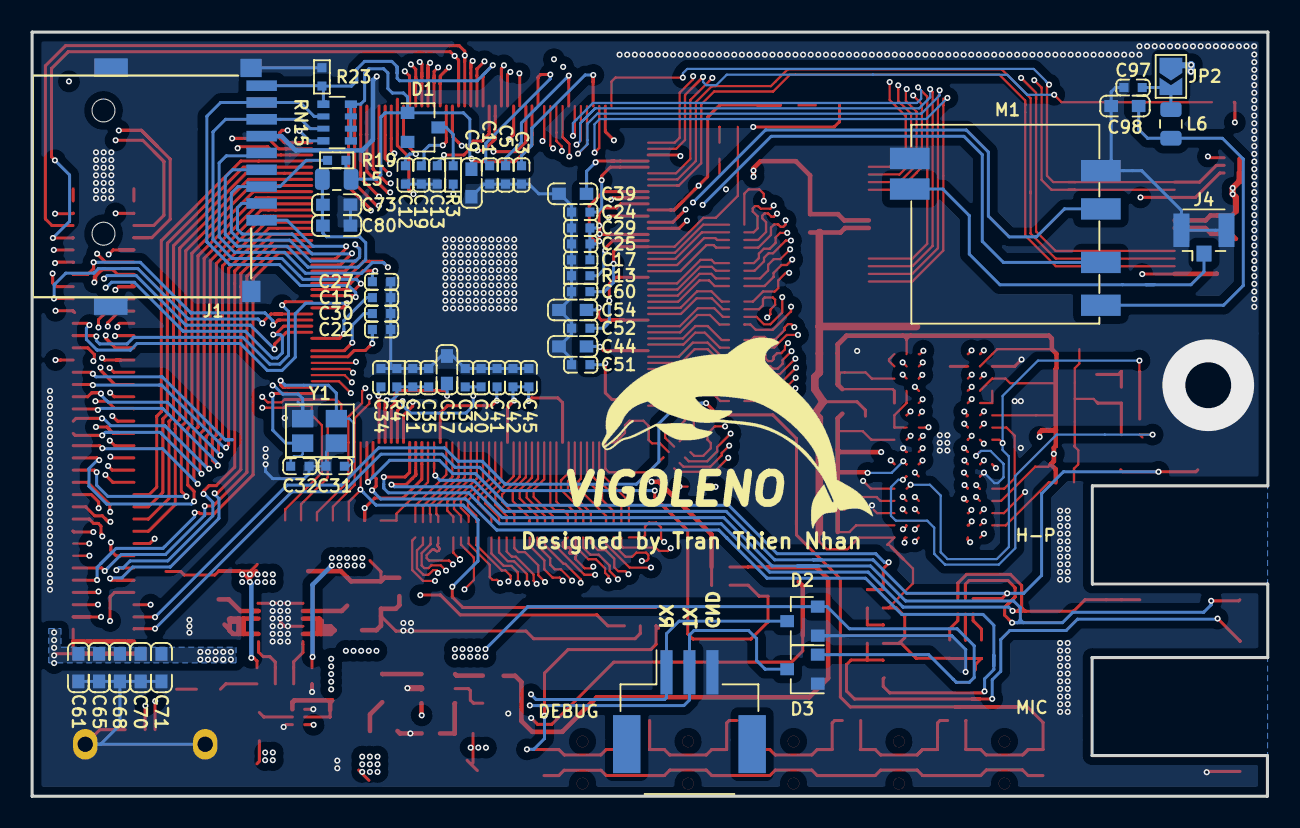
[picture p8: board vigoleno.kicad_pcb from below]

Board: 6 copper layers, 80.8 x 50.0 mm, 181 parts (60 on the bottom side), 233 nets.
