mfkiwl/vigoleno-V1.0-A13SOM/(commit log)

2018-12-03 add schematic
    [vigoleno.kicad_pcb, vigoleno.sch]
2018-12-14 update Dec 14
    [vigoleno.kicad_pcb, vigoleno.sch]
2018-12-14 update Dec 14 2018
    [main_board.kicad_pcb, main_board.sch, power_supply.kicad_pcb, power_supply.sch]
2018-12-17 add new pcb file
2018-12-17 update Dec 17 2018
    [main_board.kicad_pcb, main_board.sch, power_supply.kicad_pcb, power_supply.sch]
2018-12-17 add pcb folder
    [main_board.kicad_pcb, main_board.sch, power_supply.kicad_pcb, power_supply.sch]
2018-12-19 update vigoleno pcb
    [main_board.kicad_pcb, main_board.sch, power_supply.kicad_pcb, power_supply.sch]
2018-12-19 update Dec 19 2018
    [main_board.kicad_pcb, main_board.sch, power_supply.kicad_pcb, power_supply.sch, vigoleno.kicad_pcb, vigoleno.sch]
2018-12-20 update Dec 20 2018
    [vigoleno.kicad_pcb]
2018-12-21 update Dec 21 2018
    [vigoleno.kicad_pcb]
2018-12-24 update Dec 24 2018
    [vigoleno.kicad_pcb]
2018-12-25 update Dec 25 2018
    [vigoleno.kicad_pcb]
2019-01-05 update JAN 5 2019
    [vigoleno.kicad_pcb]
2019-01-06 update Jan 6 2019
    [vigoleno.kicad_pcb, vigoleno.sch]
2019-01-07 update Jan 7 2019
    [vigoleno.kicad_pcb]
2019-01-08 update Documents file and Main board schematic
    [main_board.kicad_pcb, main_board.sch, power_supply.kicad_pcb, power_supply.sch, vigoleno.kicad_pcb, vigoleno.sch]
2019-01-08 update Jan 8 2019
    [vigoleno.kicad_pcb, vigoleno.sch]
2019-02-01 update Feb 1
    [vigoleno.kicad_pcb]
2019-02-25 update Feb 25 2019
    [vigoleno.kicad_pcb]
2019-02-27 update Feb 27
    [vigoleno.kicad_pcb]
2019-03-05 update March 52019
    [vigoleno.kicad_pcb, vigoleno.sch]
2019-03-06 update March 6 2019
    [vigoleno.kicad_pcb, vigoleno.sch]
2019-08-09 finished VIGOLENO SBC PCB layout
    [vigoleno-Edge.Cuts.dxf, vigoleno-F.Cu.dxf, vigoleno-F.SilkS.dxf, vigoleno.kicad_pcb, vigoleno.sch]
